iisangon-gif/Stress-Corrosion-Cracking-Test-Chamber/docs/design-notes-th.md

# บันทึกการออกแบบ (ภาษาไทย): อุปกรณ์ที่ตัดออก คำอธิบาย และการเปลี่ยนอุปกรณ์

เอกสารนี้ตอบคำถามเรื่องอุปกรณ์ของตู้พ่นหมอกน้ำเกลือ NaCl 3.5 %wt ที่ใช้ Arduino Mega 2560

---

## 0. ทำความเข้าใจให้ตรงกัน (สรุปล่าสุด)

### 0.1 ฮีตเตอร์ใช้ Solid State Relay — ถูกต้อง ไม่มีปัญหา

* ฮีตเตอร์ 220 VAC → **SSR-25DA** (สั่งด้วย DC 3–32 V จากขา D5, ตัดต่อไฟ AC แบบ zero-cross) + ฮีทซิงก์
* เฟิร์มแวร์สั่งฮีตเตอร์แบบ **เปิด-ปิดเป็นรอบเวลา 2 วินาที** (เช่นต้องการ 30 % → เปิด 0.6 s ปิด 1.4 s) ซึ่ง SSR-DA ทำได้สบาย ไม่ใช่ PWM ความถี่สูง
* ใส่ **KSD301 75 °C + thermal fuse ~100 °C** บน heat sink อนุกรมกับฮีตเตอร์ไว้เป็นชั้นป้องกันทางฮาร์ดแวร์ (ดูหัวข้อ 0.5)
* ถ้าใช้แผ่นฮีตเตอร์ **24 VDC** (แนะนำ เพราะฮีตเตอร์อยู่ในตู้ที่เปียกเกลือ) ให้ใช้ **DC/DC SSR** แทน SSR-25DA — SSR-25DA ใช้กับไฟ AC เท่านั้น

### 0.2 หัวพ่นหมอก: แหล่งจ่าย 5 VDC แยก + DC/DC Solid State Relay สั่งจาก D3

**ทำไมต้องมีสวิตช์:** Driver ของหัวพ่นสร้างสัญญาณ ~108 kHz ไปสั่นแผ่น piezo เมื่อได้ไฟ 5 V แต่ **ไม่มีขารับคำสั่ง** การสั่งพ่น/หยุดจึงต้องตัด-ต่อไฟที่เข้า driver
และขา Arduino จ่ายได้แค่ ~20 mA ขณะที่ 4 หัวกินรวม ~2 A — **DC/DC SSR ตัวเดียว** คุมทั้ง 4 หัวพร้อมกัน **ใช้ได้ตามที่ออกแบบ** ขา D3 เหมือนเดิม ไม่ต้องแก้โค้ด

```
D3  ──► SSR input (+)  [3]
GND ──► SSR input (−)  [4]      (กระแสอินพุต ~7–12 mA ขา Arduino จ่ายได้)
```

**จุดที่ต้องระวังของ DC/DC SSR: แรงดันตกคร่อม (on-state voltage drop)**
SSR แบบ DC มักมีแรงดันตกคร่อม **0.1–1.5 V** ขึ้นกับรุ่นและกระแส (รุ่นที่ภายในเป็น MOSFET ตกน้อย, รุ่นถูกที่เป็นทรานซิสเตอร์ตกมาก)
ที่ไฟ 5 V แค่ตก 0.5 V ก็เหลือ 4.5 V ซึ่ง driver บางรุ่นจะพ่นอ่อนลงหรือไม่ทำงาน — จึงแนะนำให้ **วาง SSR ตามแบบใดแบบหนึ่งนี้**:

| แบบ | การต่อ | ข้อดี | หมายเหตุ |
|---|---|---|---|
| **1. SSR อยู่ฝั่ง 12 V ก่อน Step-Down (แนะนำ ถ้า Step-Down จาก 12 V Adapter)** | 12 V Adapter (+) → **SSR out (+) [1] → (−) [2]** → Step-Down IN+ ; Step-Down OUT 5 V → driver 4 หัว | **แรงดันตกของ SSR ไม่มีผล** เพราะ step-down ยังรักษา 5 V ไว้ได้ กระแสฝั่ง 12 V แค่ ~1 A (ครึ่งหนึ่งของฝั่ง 5 V) และ 12 V อยู่ในช่วงแรงดันโหลดของ SSR ทุกรุ่น | step-down เริ่มจ่ายไฟในไม่กี่มิลลิวินาที → ยังพ่นสั้น 0.3 s ได้ |
| **2. SSR อยู่ฝั่ง 5 V (ถ้าใช้ Power Supply 5 V แยก)** | 5 V PSU (+) → **SSR out (+) [1] → (−) [2]** → driver (+) ; driver (−) → PSU (−) | ต่อง่าย | **เช็กสเปก SSR:** ช่วงแรงดันโหลดต้องครอบคลุม 5 V (เช่น "3–32 VDC" หรือ "5–60 VDC"), กระแส ≥ 10 A (เผื่อ inrush ของ driver), **วัดแรงดันที่ขั้ว driver ขณะพ่นครบ 4 หัวต้อง ≥ 4.75 V** ถ้าไม่ถึง ให้ตั้ง PSU (ถ้าปรับได้) ขึ้นเป็น ~5.3 V หรือย้ายไปแบบ 1 |

ทั้งสองแบบเป็นสวิตช์ DC ที่เปิด-ปิดเร็ว (มิลลิวินาที) → ใช้ค่าเริ่มต้น **`MIST_AC_SIDE_SWITCH 0`** (พ่นสั้นสุด 0.3 s, รอบ 4 s)
ใช้ค่า `1` เฉพาะกรณีที่ตัดไฟ **220 V** ที่เข้า adapter USB (adapter ใช้เวลา ~0.5 s กว่าจะจ่ายไฟ → พ่นสั้นสุด ~1 s)

**ข้อควรระวังอื่น:**
* **ขั้วเอาต์พุตของ SSR DC มีขั้ว (+/−)** ต่อกลับขั้วจะไม่ทำงาน/เสีย
* **กระแสรั่วขณะปิด (off-state leakage)** ของ SSR DC ~1–5 mA ปกติไม่พอให้ driver ทำงาน แต่ถ้าพบว่าหัวพ่นยังพ่นอ่อน ๆ ตอนสั่งปิด ให้ต่อ R 1 kΩ / 0.5 W คร่อมขั้วไฟเข้า driver เพื่อดึงไฟรั่วลง
* **ขนาดแหล่งจ่าย:** 4 หัว × ~0.5 A ≈ 2 A (ตรวจจากฉลากหัวพ่นจริง) → Step-Down **≥ 5 A** (เช่น XL4015 5 A; LM2596 "3 A" ใช้ต่อเนื่องได้จริงแค่ ~2 A ไม่พอ) และ 12 V Adapter ≥ 3 A (step-down ~1 A + พัดลม + Arduino)
* **GND ร่วม:** ฝั่งอินพุตของ SSR แยกไฟ (opto) แล้ว จึงไม่จำเป็นต้องต่อ GND ของ 5 V เข้ากับ Arduino

ทำไมช่วงพ่นสั้นสำคัญ: ช่วงพ่นสั้นสุดกำหนดว่า RH จะแกว่งมากแค่ไหน ในตู้ **200 ลิตร** หัวพ่น 4 หัวทำให้ RH ขึ้นเพียง **~0.25 %RH ต่อการพ่น 0.5 วินาที** (ที่ 35 °C)
จึงผ่าน ±2 %RH สบายทั้งสองแบบ (จำลอง: RH แกว่ง ~±0.3 %RH ทั้ง DC/DC SSR และแบบตัดไฟ 220 V) — แต่ถ้าเป็นตู้เล็ก 40–60 ลิตร จะขึ้น ~1 %RH ต่อ 0.5 วินาที และแบบตัดไฟ 220 V (พ่นสั้นสุด ~1 s) แกว่งถึง ±2.2 %RH

* **ไม่ใช้รีเลย์กลไก** เพราะเปิด-ปิดทุกไม่กี่วินาที อายุหน้าสัมผัสจะหมดเร็ว

ข้อความเก่าที่พูดถึง `PIN_PUMP` (ปั๊มพ่นน้ำเกลือ) มาจากดีไซน์รุ่นแรก **ไม่ใช้แล้ว** — ปัจจุบันขา D3 (`PIN_MIST`) คือสวิตช์ไฟของหัวพ่นหมอก Ultrasonic

### 0.3 หัวพ่นหมอกใช้ "จับเวลาพ่น" ใช่ไหม — ใช่

ทั้งหัวพ่นและฮีตเตอร์ใช้วิธีเดียวกันคือ **เปิด-ปิดตามสัดส่วนเวลา (time-proportioning)** ไม่มีตัวไหนใช้ PWM ความถี่สูงแล้ว ต่างกันแค่ความยาวรอบ:

| เอาต์พุต | รอบเวลา | ตัวอย่าง: ระบบคำนวณว่าต้องการ 20 % |
|---|---|---|
| ฮีตเตอร์ (SSR) | 2 s | เปิด 0.4 s / ปิด 1.6 s |
| หัวพ่นหมอก (DC/DC SSR หรือ MOSFET) | 4 s | **พ่น 0.8 s / หยุด 3.2 s** |
| หัวพ่นหมอก (SSR ตัดไฟ 220 V ของ adapter) | 6 s | พ่น 1.2 s / หยุด 4.8 s |
| พัดลมเติมอากาศ | 10 s | เปิด 2 s / ปิด 8 s |

ระยะเวลาพ่นในแต่ละรอบ **ไม่คงที่** — ตัวควบคุม (PI) คำนวณใหม่ทุก 2 วินาทีจากความชื้นที่วัดได้: ยิ่ง RH ต่ำกว่าค่าตั้งมาก ยิ่งพ่นนาน
ถ้าต้องการพ่นน้อยกว่าเวลาพ่นสั้นสุด (0.3 s) ระบบจะ "เก็บสะสม" ไว้แล้วพ่นในรอบถัดไป เช่น ต้องการ 5 % = 0.2 s ต่อรอบ → พ่น 0.4 s ทุก 2 รอบ ค่าเฉลี่ยจึงยังถูกต้อง

---

## 0.4 ช่วงการทำงานของตู้

| ค่า | ช่วงที่ตั้งได้ | วิธีควบคุม |
|---|---|---|
| อุณหภูมิ | **20–40 °C** หรือ **ROOM** | ฮีตเตอร์ (ทำความร้อนได้อย่างเดียว ไม่มีระบบทำความเย็น) |
| ความชื้น | **20–80 %RH** | **หมอกน้ำเกลือเป็นหลัก** (เพิ่ม RH), พัดลมเติมอากาศช่วยลด RH |

**โหมด ROOM (อุณหภูมิห้อง):** ในเมนู Set Temperature กด LEFT ต่ำกว่า 20.0 จะเป็น `ROOM` (หรือพิมพ์ `SET T ROOM`)
→ ปิดฮีตเตอร์ วัดและบันทึกอุณหภูมิอย่างเดียว ควบคุมเฉพาะความชื้นด้วยหมอก (ไม่เช็กช่วง ±1 °C แต่ alarm อุณหภูมิเกิน 60 °C ยังทำงาน)

**ข้อจำกัดทางฟิสิกส์ที่ต้องรู้:**

1. **อุณหภูมิต้องสูงกว่าห้องอย่างน้อย ~3 °C** เพราะไม่มีระบบทำความเย็น ถ้าห้อง 30 °C จะตั้ง 20–32 °C ไม่ได้ → ใช้โหมด ROOM หรือวางตู้ในห้องแอร์
2. **หมอกเพิ่มความชื้นได้อย่างเดียว ลดไม่ได้** RH ที่ต่ำที่สุดที่ทำได้ = ความชื้นของอากาศห้องที่เป่าเข้าไป (เมื่ออุ่นขึ้นเป็นอุณหภูมิตู้):

| อากาศห้อง | ตู้ 25 °C | ตู้ 30 °C | ตู้ 35 °C | ตู้ 40 °C |
|---|---|---|---|---|
| 25 °C / 50 %RH (ห้องแอร์) | 50 % | 37 % | 28 % | **21 %** |
| 25 °C / 60 %RH | 60 % | 45 % | 34 % | 26 % |
| 30 °C / 60 %RH | – | 60 % | 45 % | 34 % |
| 30 °C / 70 %RH (ห้องปกติในไทย) | – | 70 % | 53 % | 40 % |

   ถ้าต้องการ RH ต่ำกว่าตาราง (เช่น 20–30 %RH ที่ 25–30 °C) ต้องใช้ **อากาศแห้ง**: ใส่ **กระบอกซิลิกาเจล (desiccant) ที่ทางเข้าของพัดลมเติมอากาศ**
   (ไม่ต้องเพิ่มขาหรือแก้โค้ด — พัดลมตัวเดิมเป่าอากาศแห้งเข้า) ซิลิกาเจลต้องอบไล่ความชื้นเป็นระยะ หรือใช้ลมอัดแห้ง (compressed dry air) แทน

3. **หมอกเกลือที่ RH ต่ำกว่า ~75 %RH:** NaCl มีจุด deliquescence ที่ ~75 %RH — ต่ำกว่านี้หยดน้ำเกลือที่เกาะชิ้นงานจะแห้งเป็นผลึกเกลือ
   ซึ่งเป็นสภาวะที่ใช้ศึกษาการสะสมคลอไรด์และวัฏจักรเปียก-แห้งได้ แต่การกัดกร่อนจะช้าลงมากเมื่อเกลือแห้ง ควรออกแบบโปรไฟล์ทดสอบให้สอดคล้องกับวัตถุประสงค์

---

## 0.5 ตู้ทดสอบ 50 × 80 × 50 cm (พลาสติก) และฮีตเตอร์ภายในตู้

### ขนาดและภาระความร้อน

| รายการ | ค่า |
|---|---|
| ขนาดภายใน (W × L × H) | 50 × 80 × 50 cm → **ปริมาตร 200 ลิตร**, พื้นที่ผิว 2.1 m² |
| การสูญเสียความร้อนผ่านผนังพลาสติก 5 mm (ไม่หุ้มฉนวน) | ~6.6 W/K |
| หุ้มฉนวน XPS/PE foam 20 mm ด้านนอก | ~2.3 W/K (ลดลง ~3 เท่า) |
| ความร้อนที่หมอกใช้ระเหย (latent heat) | สูงสุด ~95 W เมื่อพ่นต่อเนื่อง 4 หัว (~26 W ที่ 40 °C / 80 %RH) |
| หัวพ่น 4 หัว (~35 mL/h ต่อหัว) ในตู้ 200 L | พ่นประมาณ 7–28 % ของเวลา เพื่อรักษา 35–40 °C / 70–80 %RH — **4 หัวเพียงพอ** |

กำลังฮีตเตอร์ที่ต้องใช้ (ห้อง 25 °C → ตู้ 40 °C / 80 %RH รวมความร้อนระเหยของหมอก):

| | ภาระคงที่ | แนะนำฮีตเตอร์ (เผื่ออุ่นเครื่อง ~2 เท่า) |
|---|---|---|
| ตู้หุ้มฉนวน 20 mm | ~70 W | **200 W** |
| ตู้ไม่หุ้มฉนวน | ~135 W | **300 W** |

ผลจำลอง (ตู้ 200 L, ฮีตเตอร์ในตู้ + พัดลม, 16 กรณี รวมฮีตเตอร์ 100–300 W, หุ้ม/ไม่หุ้มฉนวน, หมอกอ่อน/แรง, ห้องไทย 30 °C / 70 %):
**ผ่าน ±1 °C / ±2 %RH ทุกกรณี** — แย่สุด ±0.71 °C, ±1.26 %RH (ตอนฟื้นตัวหลังเปิดฝา)

**ชนิดพลาสติกของตู้:** PP หรืออะคริลิก (ทนได้ถึง ~70–100 °C) เหมาะสม — **PVC อ่อนตัวที่ ~60–70 °C** ถ้าใช้ PVC ให้ฮีตเตอร์ห่างผนัง ≥ 5 cm
ติดตั้งชุดฮีตเตอร์บนขาตั้ง/standoff ไม่ให้ครีบหรือแผ่นฮีตเตอร์แตะผนังพลาสติก

### ฮีตเตอร์อยู่ในตู้: Silicone rubber heater pad + Al heat sink มีครีบ + พัดลม — ความเสี่ยงจาก corrosion

ใช่ **มีความเสี่ยงจริง** และมีความเสี่ยงด้านไฟฟ้าด้วย:

| ชิ้นส่วน | ความเสี่ยงในหมอกเกลือ 3.5 % | ผล |
|---|---|---|
| **Al heat sink** | คลอไรด์ทำให้เกิด **pitting** โดยเฉพาะที่ครีบร้อนซึ่งหยดน้ำเกลือระเหยทิ้ง **คราบเกลือ** ไว้ (คราบดูดความชื้นกลับ → กัดกร่อนต่อเนื่อง) | ประสิทธิภาพถ่ายเทความร้อนลด, ผงขาว Al(OH)₃ หลุดปนเปื้อนตู้/ชิ้นงาน |
| **Silicone pad** | ตัวยางซิลิโคนทนเกลือได้ดี แต่ **ขอบกาวและจุดสายไฟออก** น้ำเกลือซึมเข้าได้ | แผ่นหลุดลอก, **ไฟรั่ว** |
| **ไฟ 230 V ในตู้เปียกเกลือ** | ฟิล์มน้ำเกลือนำไฟฟ้า | **อันตรายจากไฟดูด**, เบรกเกอร์กันดูดตัด |
| **พัดลม** | ลูกปืนติด, แผงวงจรมอเตอร์ถูกกัด | พัดลมหยุด → ฮีตเตอร์ร้อนเกิน |
| **ขั้วต่อ/สายไฟในตู้** | ทองแดงเป็นสนิมเขียว | ต่อไม่ติด, ร้อนที่จุดต่อ |

**แนวทางลดความเสี่ยง (เรียงตามความสำคัญ):**

1. **ใช้ฮีตเตอร์แรงดันต่ำ 24 VDC (SELV) แทน 230 VAC** — ปลอดภัยจากไฟดูดแม้ฉนวนเสื่อม
   แผ่นซิลิโคน 24 V 200–300 W มีขาย, ใช้ Power Supply 24 V ≥ 15 A, สวิตช์ด้วย **DC/DC SSR** (แบบเดียวกับหัวพ่น) จากขา D5 — ไม่ต้องแก้โค้ด
   ถ้าจำเป็นต้องใช้ 230 V: **ต่อสายดินที่ heat sink**, ใช้ **RCD/RCBO 30 mA**, และสาย/จุดต่อทั้งหมดอยู่นอกตู้
2. **เคลือบป้องกัน Al heat sink** (เลือกอย่างใดอย่างหนึ่ง):
   * Hard anodize + seal (ดีที่สุดสำหรับ Al, ความร้อนผ่านได้ดี)
   * Epoxy / powder coat บาง ๆ 50–80 µm (ความร้อนลดลงเล็กน้อย ~5–10 %)
   * หรือเปลี่ยนวัสดุครีบเป็น **สแตนเลส 316** (นำความร้อนต่ำกว่า ต้องครีบใหญ่ขึ้น) หรือ **ไทเทเนียม** (ทนที่สุด แพง)
3. **ปิดผนึกแผ่นฮีตเตอร์และสายไฟ**:
   * ทาขอบแผ่นซิลิโคนด้วย **RTV silicone ชนิด neutral cure** (ห้ามใช้ชนิด acetoxy/กลิ่นน้ำส้มสายชู เพราะกรดอะซิติกกัดโลหะ)
   * ใช้สายหุ้มซิลิโคนเส้นเดียวยาวต่อเนื่อง **ไม่มีจุดต่อในตู้** ออกผ่าน cable gland ไปต่อในกล่องควบคุม
4. **วางชุดฮีตเตอร์ให้ห่างละอองหมอก**: ตั้งไว้มุมตรงข้ามกับหัวพ่น มี **แผ่นกันหยด (drip shield)** ด้านบน ให้พัดลมดูดอากาศผ่านครีบ ไม่ใช่ให้หมอกพ่นใส่ครีบ — ครีบร้อน + หยดน้ำเกลือ = คราบเกลือสะสมเร็วที่สุด
5. **พัดลม**: ใช้ **IP68 brushless** (มอเตอร์และแผงวงจรถูก potting) และถือเป็นของสิ้นเปลือง พัดลมนี้คือ `PIN_CIRC_FAN` (D7) ซึ่งเปิดตลอดเวลาที่ระบบ RUN — ฮีตเตอร์จึงไม่ทำงานโดยไม่มีลม
6. **ป้องกันความร้อนเกินเมื่อพัดลมเสีย** (ซอฟต์แวร์ตรวจไม่ได้ว่าพัดลมหมุน):
   * **Bimetal thermostat KSD301 ชนิด NC 75 °C** ยึดบน heat sink อนุกรมกับฮีตเตอร์ (ตัดอัตโนมัติ, ต่อกลับเมื่อเย็น)
   * **Thermal fuse ~100 °C** อนุกรมอีกชั้น (ตัดถาวร)
   * ปกติ heat sink ร้อนกว่าอากาศ ~20 °C ที่กำลังเต็ม (สูงสุด ~60 °C ที่ตู้ 40 °C) จึงไม่ตัดผิดจังหวะ
7. **ออกแบบให้ถอดเปลี่ยนง่าย**: ทำชุดฮีตเตอร์ + พัดลมเป็นโมดูลเดียว ต่อด้วยขั้วต่อกันน้ำนอกตู้ — ล้างด้วยน้ำ DI หลังทดสอบทุกครั้ง และตรวจสภาพทุกเดือน

**ทางเลือกที่หลีกเลี่ยง corrosion ได้ดีกว่า** (ถ้าออกแบบใหม่ได้): แปะแผ่นฮีตเตอร์ไว้ **ด้านนอก** ของผนัง/พื้นที่ทำจาก **แผ่นอะลูมิเนียมบางเคลือบ epoxy ด้านใน**
แล้วใช้พัดลม IP68 ในตู้ช่วยกวนอากาศ — ฮีตเตอร์และไฟ 230 V ไม่สัมผัสหมอกเลย (ดูหัวข้อ 2.4) แต่การถ่ายเทความร้อนช้ากว่าแบบฮีตเตอร์ในตู้

---

## 1. บอร์ด Arduino Mega 2560, Buzzer, LED แสดงสถานะ และอุปกรณ์ที่ไม่ติดตั้ง

**เปลี่ยนเป็น Arduino Mega 2560:** Flash ใช้ ~34 KB จาก 256 KB และ RAM ~1.5 KB จาก 8 KB จึงเหลือที่และขาว่างอีกมากสำหรับต่อเพิ่มภายหลัง
(โค้ดจะไม่ยอม compile ถ้าเลือกบอร์ดเป็น UNO เพื่อป้องกันการอัปโหลดผิดบอร์ด เพราะขา LED D22–D28 มีเฉพาะบน Mega)

| ขา Mega | อุปกรณ์ | หมายเหตุ |
|---|---|---|
| D2 | DHT22 | |
| D3 | DC/DC SSR → หัวพ่นหมอก 4 หัว | |
| D5 | SSR → ฮีตเตอร์ | |
| D6 | พัดลมเติมอากาศ | |
| D7 | พัดลมผ่านครีบฮีตเตอร์ | |
| **D8** | **Buzzer 5 V** (ใส่กลับมาแล้ว) | |
| **D22** | **LED เขียว RUN** | ติดค้าง = อยู่ในช่วง ±1 °C / ±2 %RH, กะพริบช้า = กำลังเข้าสู่ค่าตั้ง, ดับ = หยุด |
| **D24** | **LED แดง ALARM** | กะพริบเร็ว = alarm ใหม่, ติดค้าง = รับทราบแล้วแต่ยังมี alarm, ดับ = ปกติ |
| **D26** | **LED เหลือง/ส้ม HEATER** | ติดเมื่อฮีตเตอร์ทำงาน |
| **D28** | **LED น้ำเงิน MIST** | ติดเมื่อหัวพ่นทำงาน |
| D20/D21 (SDA/SCL) | LCD shield + **โมดูล DS3231** | LCD ใช้ขา SDA/SCL ข้าง AREF, DS3231 ต่อสายเข้าขาเดียวกัน |
| D50 / D51 / D52 / D53 | **โมดูล Micro SD 6 ขา** (MISO / MOSI / SCK / CS) | VCC ต่อ 5 V, ใช้รุ่นที่มี AMS1117 + 74LVC125A, สายสั้น ≤ 15–20 cm (ดู wiring.md §1.1) |

* **ต่อ LED:** ขา → R 330 Ω → LED → GND (หรือใช้ LED ติดหน้าตู้แบบ 5 V ที่มี R ในตัว) ถ้าเป็นหลอดไฟ 12/24 V ต้องขับผ่าน MOSFET/ทรานซิสเตอร์
* **ปุ่มแบบมีไฟในตัว** ยังใช้ได้ โดยต่อ LED ของปุ่มเข้ากับ D22–D28 แทน LED ธรรมดา
* **ตอนเปิดเครื่อง:** LED ทั้ง 4 ดวงติดพร้อมกัน และ Buzzer ดังสั้น 1 ครั้ง (lamp test) เพื่อเช็กว่าทำงานครบ

**Data Logging (แบบ A):** ใช้ **โมดูล Micro SD 6 ขา + โมดูล DS3231** แยกกัน แทน Data Logging Shield
ค่าใน `config.h` ตั้งไว้ให้แล้ว: `RTC_IS_PCF8523 0` (DS3231) และ `PIN_SD_CS 53`
* DS3231 รุ่น ZS-042 มีวงจรชาร์จถ่าน — ใช้ถ่าน **LIR2032** (ชาร์จได้) หรือถ้าใช้ CR2032 ให้ถอดไดโอด/R ชาร์จออก
* ใส่ DS3231 ครั้งแรกแล้วตั้งเวลา 1 ครั้ง: `TIME 2026-10-14 09:00:00`

**ต่ออุปกรณ์ทีละชิ้นได้ — โค้ดรันได้แม้อุปกรณ์ยังไม่ครบ:**

| ยังไม่มี | ผล |
|---|---|
| Micro SD / การ์ด | บันทึกผ่าน USB (Serial) ต่อไป, จอหน้า Log ขึ้น `SD --` |
| DS3231 | เวลาในข้อมูลเป็น "วินาทีนับจากเปิดเครื่อง", ไฟล์ชื่อ `DATALOG.CSV` |
| จอ LCD | ควบคุมทำงานปกติ ตั้งค่าผ่าน Serial |
| DHT22 | `!SENSOR FAIL` — **ปิดฮีตเตอร์และหัวพ่นไว้** (ป้องกันความปลอดภัย) และ Buzzer ดัง |
| SSR / โหลด / LED / Buzzer | ขายังสั่งงานปกติ (ดู LED ส้ม/น้ำเงินเพื่อเช็กลอจิกก่อนต่อโหลดจริง) |

* **ตอนเปิดเครื่อง** Serial Monitor แสดงบรรทัดเดียวว่าเจออะไรบ้าง เช่น `# LCD OK | RTC OK 2026-10-14 09:00:00 | SD not found | DHT22 OK` และพิมพ์ `DEVICES` เพื่อดูอีกครั้งได้ตลอด
* **ระบบค้นหาอุปกรณ์ที่ขาดทุก 1 นาที** — ใส่การ์ด SD / DS3231 / จอ ทีหลังได้โดย **ไม่ต้องกด Reset** (ขึ้นข้อความ `# SD card found`, `# RTC found`, `# LCD found`)
  ระหว่างค้นหาการ์ด SD ที่ยังไม่มี (ใช้เวลา ~2 วินาที) ระบบจะปิดฮีตเตอร์และหัวพ่นไว้ชั่วคราวเพื่อความปลอดภัย
* **ดึงการ์ดออกระหว่างทำงาน** ระบบยังควบคุมต่อ แจ้ง `SD write failed` แล้วค้นหาใหม่เอง
* **บัส I²C มี timeout** — ถ้าสาย I²C หลวม/ช็อต ระบบจะ reset บัสแทนการค้าง
* **ต่อ/ถอดอุปกรณ์ตอนปิดไฟเสมอ**
* เมนู **Reset stats** กลับมาแล้ว (ตอน UNO ต้องตัดออกเพราะหน่วยความจำไม่พอ)

**ไม่ติดตั้ง (ตามที่เลือก):**

| ไม่ติดตั้ง | ผลกระทบ / สิ่งที่ทดแทน |
|---|---|
| ลูกลอยระดับน้ำเกลือ | ผู้ใช้ต้อง **ตรวจระดับน้ำเกลือเอง** ถ้าน้ำหมด ความชื้นจะตกจนเกิด alarm `!OUT OF BAND` แล้ว Buzzer และ LED แดงจะเตือน |
| Reed switch ฝาตู้ | ก่อนเปิดฝาให้สั่ง **STOP** (เมนู Run / Stop หรือพิมพ์ `STOP`) แล้วกด RUN เมื่อปิดฝา |
| DS18B20 | ใช้ DHT22 ตัวเดียววัดทั้ง T และ RH |

ถ้าต้องการเพิ่มภายหลัง Mega มีขาว่างเหลือ: D4, D9, D11–D13, D23, D25, D27, D29–D49, A0–A15

---

## 2. คำอธิบายอุปกรณ์

### 2.1 ทำไมขา `PIN_ONEWIRE` ต้องต่อ R 4.7 kΩ ไป 5 VDC

1-Wire (DS18B20) และสายข้อมูลของ DHT22 เป็นบัสแบบ **open-drain** อุปกรณ์ทุกตัวบนสาย **ดึงสายลง 0 V ได้อย่างเดียว ดึงขึ้นเองไม่ได้**

* เวลาไม่มีใครดึงลง ตัวต้านทาน pull-up จะดึงสายกลับขึ้นเป็น 5 V (logic 1) ถ้าไม่มี สายจะ "ลอย" อ่านค่าเพี้ยนหรืออ่านไม่ได้เลย
* ค่า **4.7 kΩ** เป็นจุดสมดุล ต่ำพอให้สายขึ้นเป็น 1 ได้เร็ว (สายยาวมีความจุ ถ้า R สูงเกิน ขอบสัญญาณจะช้าจนอ่านบิตผิด) และสูงพอให้อุปกรณ์ดึงลงได้โดยกินกระแสไม่เกิน ~1 mA
* DS18B20 แบบ parasite power ยังใช้ pull-up นี้เป็นแหล่งจ่ายไฟด้วย
* pull-up ภายในของ Arduino (~20–50 kΩ) อ่อนเกินไปสำหรับสายยาว

ในดีไซน์ปัจจุบันใช้ **DHT22** ซึ่งก็ต้องใช้ pull-up ด้วยเหตุผลเดียวกัน (4.7–10 kΩ) แต่ **AM2302 รุ่นมีสายมี pull-up ในตัวแล้ว** ไม่ต้องต่อเพิ่ม ถ้าใช้ DHT22 แบบ 4 ขาเปล่า ให้ต่อ 10 kΩ จาก DATA ไป 5 V (สายยาวเกิน 3 m ใช้ 4.7 kΩ)

### 2.2 Buzzer (D8) และ LED แดง แจ้งเตือนตอนไหน

Buzzer ดัง (0.4 s ทุก 1.2 s) และ LED แดงกะพริบเร็ว เมื่อมี alarm ที่ยังไม่ได้รับทราบ:

| Alarm | เกิดเมื่อ | ระบบทำอะไร |
|---|---|---|
| `!SENSOR FAIL` | DHT22 อ่านไม่ได้ 3 ครั้งติด (6 s) | ปิดฮีตเตอร์และหัวพ่นทันที |
| `!OVER TEMP` | อุณหภูมิ ≥ 60 °C | ปิดฮีตเตอร์และหัวพ่น เปิดพัดลมเติมอากาศ 100 % |
| `!OUT OF BAND` | หลังเข้าสู่ช่วงเสถียรแล้ว T หรือ RH หลุดช่วง ±1 °C / ±2 %RH นานเกิน 10 นาที (เช่น น้ำเกลือหมด, ลืมปิดฝา, ฮีตเตอร์เสีย) | แจ้งเตือนอย่างเดียว ยังควบคุมต่อ |

* **กดปุ่มใดก็ได้บน LCD shield = รับทราบ:** Buzzer เงียบ และ LED แดงเปลี่ยนจากกะพริบเป็น **ติดค้าง** จนกว่าปัญหาจะหายหรือมี alarm ใหม่ (ซึ่งจะดังอีกครั้ง)
* ไฟพื้นหลัง LCD เป็น **สีแดง** ตลอดเวลาที่มี alarm
* Buzzer แบบ active 5 V ที่กินกระแส ≤ 20 mA ต่อตรงขา D8 ได้ ถ้าเป็น buzzer เสียงดัง 12 V ให้ขับผ่าน MOSFET/ทรานซิสเตอร์

### 2.3 ทำไมใช้ MOSFET — ใช้ Solid State Relay (SSR) แทนได้ไหม

**ใช้ SSR ได้** เฟิร์มแวร์ปรับแล้วให้ **ทุกเอาต์พุตเป็นแบบ on/off ตามสัดส่วนเวลา (time-proportioning)** ไม่ได้ใช้ PWM ความถี่สูงแล้ว:

| เอาต์พุต | หน้าต่างเวลา | ตัวอย่าง: 25 % |
|---|---|---|
| ฮีตเตอร์ | 2 s | ON 0.5 s / OFF 1.5 s |
| หัวพ่นหมอก 4 หัว | 4 s (MOSFET) / 6 s (SSR) | ON 1.0 s / OFF 3.0 s |
| พัดลมเติมอากาศ | 10 s | ON 2.5 s / OFF 7.5 s |

เหตุผล: PWM 980 Hz (`analogWrite`) **ใช้กับ SSR ไม่ได้** เพราะ SSR AC แบบ zero-cross จะเปิด/ปิดได้เฉพาะตอนแรงดันไฟ AC ผ่านศูนย์ (ทุก 10 ms ที่ 50 Hz) จึงต้องใช้รอบเวลาช้าระดับวินาที ซึ่งตอนนี้รองรับแล้ว

เลือกอุปกรณ์สวิตช์ตามชนิดโหลด:

| โหลด | อุปกรณ์ที่เหมาะ | หมายเหตุ |
|---|---|---|
| ฮีตเตอร์ **220 VAC** | **SSR-25DA** (DC in 3–32 V, AC out, zero-cross) + ฮีทซิงก์ | ดีที่สุดสำหรับฮีตเตอร์ AC: แยกไฟ (isolation), ไม่มีหน้าสัมผัสสึก, ไม่มีสัญญาณรบกวน |
| ฮีตเตอร์/พัดลม **12 VDC** | MOSFET module (logic-level) หรือ **SSR แบบ DC-DC** (เช่น SSR-10DD) | **ห้ามใช้ SSR-DA (AC out) กับไฟ DC** — มันจะปิดไม่ได้ เพราะไม่มีจุดผ่านศูนย์ |
| หัวพ่นหมอก **5 V** (driver 4 หัว) | **DC/DC SSR** (เลือกใช้) หรือ MOSFET module | วาง SSR **ฝั่ง 12 V ก่อน step-down** ดีที่สุด; ถ้าวางฝั่ง 5 V ต้องเช็กแรงดันตกคร่อม (ดูหัวข้อ 0.2) |
| ทุกชนิด | **ห้ามใช้รีเลย์กลไก** กับหัวพ่นและฮีตเตอร์ | เปิด-ปิดทุก 2–5 วินาที = ~20,000 ครั้ง/วัน รีเลย์ (อายุ ~100,000 ครั้ง) จะพังภายในประมาณ 1 สัปดาห์ |

เปรียบเทียบ MOSFET vs SSR:

| | MOSFET module | SSR |
|---|---|---|
| ราคา | ถูก | แพงกว่า (ระวังของปลอม) |
| ความร้อน/แรงดันตก | น้อยมาก (mΩ) | DA: ~1.5 V, ต้องมีฮีทซิงก์เมื่อ > 5 A |
| แยกไฟ (isolation) | ไม่แยก (GND ร่วม) | **แยกด้วย opto** ปลอดภัยกว่าเมื่อคุมไฟบ้าน |
| คุมไฟ AC 220 V | ไม่ได้ | ได้ (SSR-DA) |
| คุมไฟ DC แรงดันต่ำ | ดีมาก | ได้ (SSR-DD) — มีแรงดันตกคร่อม 0.1–1.5 V จึงควรวางฝั่ง 12 V |

**สรุป (ตามที่เลือกใช้):** **SSR-25DA** สำหรับฮีตเตอร์ 220 VAC (D5) และ **DC/DC SSR** สำหรับไฟของหัวพ่นหมอก (D3) วางฝั่ง 12 V ก่อน step-down —
พัดลม 12 V (D6, D7) ใช้ DC/DC SSR หรือ MOSFET module ก็ได้

### 2.4 ฮีตเตอร์และพัดลมจะเกิด corrosion ในหมอกน้ำเกลือ 3.5 %wt NaCl ไหม

> **อัปเดต:** ดีไซน์ปัจจุบันใช้ฮีตเตอร์ **ภายในตู้** (silicone pad + Al heat sink + พัดลม) ตามที่เลือก — ดูวิธีป้องกันที่หัวข้อ **0.5** หัวข้อนี้เก็บไว้เป็นทางเลือก "ฮีตเตอร์นอกตู้"

**เกิดแน่นอน ถ้าอยู่ในหมอกโดยตรง** หมอกเกลือคือสิ่งที่ตู้นี้ถูกสร้างมาเพื่อกัดกร่อนโลหะ:

* **ฮีตเตอร์ PTC ครีบอะลูมิเนียม / ฮีตเตอร์ขดลวด**: อะลูมิเนียมเกิด pitting, ขั้วต่อทองแดงเป็นสนิมเขียว, ครีบมีคราบเกลือเกาะ ประสิทธิภาพลดลง และเสี่ยง **ไฟรั่ว/ลัดวงจร** เพราะคราบเกลือชื้นนำไฟฟ้าได้
* **พัดลม DC ทั่วไป**: ลูกปืน/บูชฝืดและติด, แผงวงจรขับมอเตอร์ (brushless) ถูกกัดจนเสีย, ขดลวดและสายเป็นสนิม — พัดลมธรรมดาอยู่ได้ระดับ **วันถึงสัปดาห์**
* **ผลต่อการทดสอบ**: ไอออนโลหะจากชิ้นส่วนที่ผุ (Cu, Fe, Al, Zn) ปนเปื้อนหมอกและชิ้นงาน ทำให้ผลการทดสอบ SCC เพี้ยน

**วิธีแก้ในดีไซน์นี้ — เอาฮีตเตอร์และพัดลมออกไปอยู่นอกหมอก:**

1. **ฮีตเตอร์ → แผ่นฮีตเตอร์ซิลิโคน (silicone rubber heater pad) ติดผนังด้านนอกของตู้** ใต้ฉนวน ความร้อนผ่านผนังเข้าไป ไม่สัมผัสหมอกเลย
   * แนะนำทำ **พื้นหรือผนังด้านหนึ่งเป็นแผ่นอะลูมิเนียมบาง (2–3 mm) เคลือบ epoxy/PP ด้านใน** แล้วแปะ heater pad ด้านนอก เพื่อให้ความร้อนผ่านได้ดี (ผนังพลาสติกหนา ≥ 10 mm ถ่ายเทความร้อนช้า จนควบคุม ±1 °C ได้ยากหลังเปิดฝา — ดูผลจำลองกรณี `thick_wall_slow_heater`)
   * ทางเลือก: **อ่างน้ำ (water jacket) ใต้ตู้ + ฮีตเตอร์ไทเทเนียม** (แบบตู้ salt spray เชิงพาณิชย์) อุณหภูมิสม่ำเสมอมาก แต่ตอบสนองช้า ต้องจูน PID ใหม่
2. **พัดลมระบายความชื้น → พัดลมเติมอากาศ (fresh-air blower) ติดตั้งด้านนอก เป่าอากาศห้องที่สะอาดเข้าไป** ส่วนทางออกเป็นรูระบายแบบ passive (ท่อ PVC ลงด้านล่าง มีกับดักน้ำ) — มอเตอร์สัมผัสแค่อากาศห้อง ไม่ใช่หมอกเกลือ ใส่ check valve/flap กันหมอกย้อนเข้าพัดลมตอนหยุดหมุน
3. **พัดลมหมุนเวียนในตู้ (ไม่บังคับ)** — ถ้าจำเป็นต้องใช้ ให้ใช้ **พัดลมกันน้ำ IP68 แบบ brushless** เคลือบสายและจุดบัดกรีด้วย epoxy/silicone และถือเป็น **ของสิ้นเปลือง** เปลี่ยนตามรอบ หรือไม่ใช้เลยแล้วอาศัยการหมุนเวียนจากหมอกและความร้อนจากผนัง (อุณหภูมิในตู้อาจไม่สม่ำเสมอเท่า ควรวัดหลายจุดตอนทดสอบระบบ)
4. **DHT22 ก็อยู่ในหมอกเช่นกัน** ใช้รุ่นที่มีฝาครอบกรอง (PTFE/sintered), เคลือบขาและสายด้วย conformal coating, ติดในจุดที่หมอกไม่พ่นใส่ตรง ๆ และ **ตรวจสอบ/เปลี่ยนเป็นระยะ** (ค่า RH ใกล้ 100 % และคราบเกลือทำให้ค่าดริฟต์)
5. **วงจรทั้งหมด** (Arduino, MOSFET, SSR, power supply) อยู่ในกล่อง IP65 **นอกตู้** สายทุกเส้นผ่านเคเบิลแกลนด์

---

## 3. อุปกรณ์ที่เปลี่ยน: หัวพ่นหมอก Ultrasonic 4 หัว

* หัวพ่น 4 หัวมีบอร์ดขับในตัว ใช้ไฟ USB 5 V และ **ทำงานพร้อมกันทั้ง 4 หัว** จึงใช้ **เอาต์พุตเดียว (D3, `PIN_MIST`)** สวิตช์ไฟ 5 V ที่จ่ายรวมให้ทั้ง 4 หัว
* แหล่งจ่าย: **Step-Down 12→5 V ≥ 5 A** (เช่น XL4015) จาก 12 V Adapter ≥ 3 A หรือ Power Supply 5 V แยก ≥ 3 A — 4 หัว × ~0.5 A ≈ 2 A (ดูฉลากหัวพ่นจริง) สวิตช์ด้วย **DC/DC SSR ตัวเดียว** จากขา D3 (ดูหัวข้อ 0.2)
* หัวพ่นต้อง **เริ่มพ่นทันทีเมื่อได้รับไฟ** (ไม่ต้องกดปุ่ม) ไม่อย่างนั้น Arduino สั่งเปิดไม่ได้
* น้ำเกลือ 3.5 %wt: แผ่น piezo ทำงานได้ แต่ **คราบเกลือจะเกาะและแผ่นสึกเร็วกว่าน้ำเปล่า** ควรล้างด้วยน้ำ DI หลังทดสอบทุกครั้ง และเตรียมหัวสำรอง
* **ไม่ต้องทำตาม ASTM B117** — ไม่ต้องวัดอัตราการตกของหมอก (collection rate) อุณหภูมิและความชื้นตั้งได้อิสระตามที่ต้องการ
* ไม่มีลูกลอยแล้ว: **ห้ามให้น้ำเกลือในถังหมด** ถ้าหัวพ่นชนิดไม่มีระบบตัดเมื่อแห้ง แผ่น piezo จะร้อนและเสีย — เติมน้ำเกลือให้พอสำหรับรอบทดสอบ (ดูอัตราใช้น้ำจากสเปกหัวพ่น เช่น 4 × 30 mL/h ≈ 3 ลิตร/วัน ที่ duty 100 %; จริงจะใช้น้อยกว่าเพราะพ่นเป็นช่วง)

### การเตรียมน้ำเกลือ NaCl 3.5 %wt

**NaCl 35.0 g + น้ำ DI 965.0 g = สารละลาย 1,000 g** (ไม่ใช่ NaCl 35 g ในน้ำ 1 ลิตร ซึ่งจะได้ 3.38 %wt)

| ต้องการ | NaCl | น้ำ DI |
|---|---|---|
| 1 kg | 35.0 g | 965.0 g |
| 5 kg | 175.0 g | 4,825.0 g |
| 10 kg | 350.0 g | 9,650.0 g |
