iisangon-gif/Stress-Corrosion-Cracking-Test-Chamber/firmware/SCC_EnvControl/SCC_EnvControl.ino

// =====================================================================
//  SCC Chamber Environmental Control  —  Arduino Mega 2560
//
//  Controls temperature and relative humidity of the 3.5 wt% NaCl salt
//  fog inside a stress-corrosion-cracking (SCC) test chamber:
//    * DHT22 (AM2302) temperature / humidity sensor
//    * 4 x USB ultrasonic mist heads (one 5 V supply, switched together)
//                                         -> salt fog / humidity up
//    * heater outside the fog (silicone pad / SSR) -> temperature up
//    * fresh-air blower outside the fog   -> humidity / temperature down
//    * circulation fan (optional, IP68)   -> uniform chamber air
//    * 16x2 I2C LCD keypad shield (5 buttons) for set-points
//    * CSV logging to a microSD module (DS3231 time stamps) and USB serial
//    * buzzer + 4 status LEDs; every module may be fitted later
//  Every output is switched on/off (time-proportioning), so MOSFET modules,
//  DC-input solid state relays or AC SSRs can all be used.
//
//  Target tolerance: +/-1.0 degC and +/-2.0 %RH (see config.h)
//
//  Libraries (Arduino Library Manager):
//    "DHT sensor library" (Adafruit) + "Adafruit Unified Sensor"
//    "Adafruit RGB LCD Shield Library"
//    SD, Wire, EEPROM (built in)
// =====================================================================
#include <Wire.h>
#include <EEPROM.h>
#include <DHT.h>
#include <Adafruit_RGBLCDShield.h>
#include "config.h"

#if !defined(ARDUINO_AVR_MEGA2560) && !defined(HOST_SIM)
  #error "Select Tools > Board > Arduino AVR Boards > Arduino Mega or Mega 2560"
#endif

#ifdef USE_SD
  #include <SPI.h>
  #include <SD.h>
#endif
#ifdef __AVR__
  #include <avr/wdt.h>
#endif

// ---------------------------------------------------------------------
//  Settings stored in EEPROM
// ---------------------------------------------------------------------
#define CFG_MAGIC 0xEC01

struct Settings {
  uint16_t magic;
  float    tSet;
  float    rhSet;
  uint16_t logSec;
  uint8_t  running;
};
Settings cfg;

// ---------------------------------------------------------------------
//  Alarms
// ---------------------------------------------------------------------
#define ALM_SENSOR    0x01   // DHT22 not responding
#define ALM_OVERTEMP  0x02   // above T_ABS_MAX
#define ALM_BAND      0x08   // out of tolerance too long after being stable
uint8_t alarms = 0;
uint8_t alarmsMuted = 0;     // alarms acknowledged by a key press

// ---------------------------------------------------------------------
//  Hardware
// ---------------------------------------------------------------------
DHT dht(PIN_DHT, DHT_TYPE);
Adafruit_RGBLCDShield lcd;

#define LCD_I2C_ADDR 0x20      // MCP23017 on the RGB LCD shield
bool lcdOk = false;
#ifdef USE_RTC
  bool rtcOk = false;
#endif
#ifdef USE_SD
  bool sdOk = false;
#endif
unsigned long lastDeviceCheckMs = 0;

// ---------------------------------------------------------------------
//  Process values and controller state
// ---------------------------------------------------------------------
float tMeas = NAN, rhMeas = NAN;
uint8_t sensorFails = 0;

float tInt = 0, rhInt = 0;     // integral terms (%)
float rhOut = 0;               // humidity PI output, -100..+100 (split range)
float tPrev = NAN;             // for derivative on measurement
float rhPrev = NAN;
float tSlope = 0, rhSlope = 0; // filtered rate of change per s (integral gating)
float heaterPct = 0, mistPct = 0, ventPct = 0;
bool  heaterOn = false, mistOn = false, ventOn = false, circOn = false;

// statistics (valid after the chamber became stable)
bool     stable = false;
bool     inBandNow = false;   // last control step was within tolerance
unsigned long inBandSinceMs = 0;
unsigned long outBandSinceMs = 0;
uint32_t statSamples = 0, statInBand = 0;
float    maxDevT = 0, maxDevRH = 0;

unsigned long lastCtrlMs = 0, lastLogMs = 0, lastLcdMs = 0, lastKeyPollMs = 0;

// ---------------------------------------------------------------------
//  UI state
// ---------------------------------------------------------------------
enum { SCR_MAIN, SCR_OUTPUTS, SCR_STATS, SCR_LOG, SCR_COUNT };
enum { MENU_TSET, MENU_RHSET, MENU_LOG, MENU_RUN, MENU_RESET, MENU_COUNT };

uint8_t screen = SCR_MAIN;
bool    inMenu = false;
uint8_t menuItem = 0;
Settings edit;                 // working copy while in the menu
bool    resetRequested = false;
unsigned long lastKeyMs = 0;
uint8_t backlight = 0xFF;

char serialBuf[40];
uint8_t serialLen = 0;

// =====================================================================
//  Helpers
// =====================================================================
inline float clampf(float v, float lo, float hi) { return v < lo ? lo : (v > hi ? hi : v); }

void printDevices();
void checkDevices();

// tSet == 0 means "ROOM": no temperature control, temperature is only logged
#define T_ROOM 0.0f
inline bool roomMode(float tSet) { return tSet < T_SET_MIN - 0.05f; }

// Fixed-point float formatting / parsing without dtostrf, atof or
// Print::print(float) — compact code (originally written to fit an UNO).
char *fmtFixed(char *out, float v, int8_t width, uint8_t dec) {
  static const uint16_t scale[] = {1, 10, 100};
  if (dec > 2) dec = 2;
  bool neg = v < 0;
  long n = (long)((neg ? -v : v) * scale[dec] + 0.5f);
  char body[12];
  if (dec) snprintf_P(body, sizeof(body), PSTR("%s%ld.%0*ld"), neg ? "-" : "", n / scale[dec], dec, n % scale[dec]);
  else     snprintf_P(body, sizeof(body), PSTR("%s%ld"), neg ? "-" : "", n);
  snprintf_P(out, 12, PSTR("%*s"), width, body);
  return out;
}

float parseNum(const char *s) {
  float sign = 1, v = 0, div = 0;
  if (*s == '-') { sign = -1; s++; } else if (*s == '+') s++;
  if (!*s) return NAN;
  for (; *s; s++) {
    if (*s == '.' && div == 0) div = 1;
    else if (*s >= '0' && *s <= '9') { v = v * 10 + (*s - '0'); if (div) div *= 10; }
    else return NAN;
  }
  return sign * (div ? v / div : v);
}

// ---------------------------------------------------------------------
//  Minimal RTC driver (DS1307 or PCF8523, both at I2C 0x68, BCD registers)
// ---------------------------------------------------------------------
#ifdef USE_RTC
#define RTC_ADDR 0x68
#if RTC_IS_PCF8523
  #define RTC_TIME_REG 0x03   // seconds .. years
  #define RTC_DAY_IDX  3      // order: s m h day weekday month year
  #define RTC_WD_IDX   4
#else
  #define RTC_TIME_REG 0x00   // DS1307: s m h weekday day month year
  #define RTC_DAY_IDX  4
  #define RTC_WD_IDX   3
#endif

struct Clock { uint8_t yy, mo, dd, hh, mi, ss; };

inline uint8_t bcd2bin(uint8_t v) { return v - 6 * (v >> 4); }
inline uint8_t bin2bcd(uint8_t v) { return v + 6 * (v / 10); }

void rtcWriteReg(uint8_t reg, uint8_t val) {
  Wire.beginTransmission(RTC_ADDR);
  Wire.write(reg);
  Wire.write(val);
  Wire.endTransmission();
}

bool rtcBegin() {
  Wire.beginTransmission(RTC_ADDR);
  if (Wire.endTransmission() != 0) return false;
#if RTC_IS_PCF8523
  rtcWriteReg(0x00, 0x00);   // Control_1: clear STOP -> oscillator running
  rtcWriteReg(0x02, 0x00);   // Control_3: battery switch-over enabled
#endif
  return true;
}

bool rtcRead(Clock &c) {
  if (!rtcOk) return false;
  Wire.beginTransmission(RTC_ADDR);
  Wire.write(RTC_TIME_REG);
  if (Wire.endTransmission() != 0) return false;
  if (Wire.requestFrom(RTC_ADDR, 7) != 7) return false;
  uint8_t r[7];
  for (uint8_t i = 0; i < 7; i++) r[i] = Wire.read();
  c.ss = bcd2bin(r[0] & 0x7F);
  c.mi = bcd2bin(r[1] & 0x7F);
  c.hh = bcd2bin(r[2] & 0x3F);
  c.dd = bcd2bin(r[RTC_DAY_IDX] & 0x3F);
  c.mo = bcd2bin(r[5] & 0x1F);
  c.yy = bcd2bin(r[6]);
  return c.mo >= 1 && c.mo <= 12 && c.dd >= 1 && c.dd <= 31;
}

// "YYYY-MM-DD HH:MM:SS"
bool rtcSetFromText(const char *t) {
  if (strlen(t) < 19 || t[4] != '-' || t[7] != '-' || t[13] != ':' || t[16] != ':') return false;
  uint8_t v[6];
  static const uint8_t pos[6] = {2, 5, 8, 11, 14, 17};   // yy mo dd hh mi ss
  for (uint8_t i = 0; i < 6; i++) {
    if (!isdigit(t[pos[i]]) || !isdigit(t[pos[i] + 1])) return false;
    v[i] = (t[pos[i]] - '0') * 10 + (t[pos[i] + 1] - '0');
  }
  if (v[1] < 1 || v[1] > 12 || v[2] < 1 || v[2] > 31 || v[3] > 23 || v[4] > 59 || v[5] > 59) return false;
  uint8_t r[7];
  r[0] = bin2bcd(v[5]);              // seconds (clears DS1307 CH / PCF8523 OS bit)
  r[1] = bin2bcd(v[4]);
  r[2] = bin2bcd(v[3]);              // 24 h mode
  r[RTC_DAY_IDX] = bin2bcd(v[2]);
  r[RTC_WD_IDX]  = 0;                // weekday not used
  r[5] = bin2bcd(v[1]);
  r[6] = bin2bcd(v[0]);
  Wire.beginTransmission(RTC_ADDR);
  Wire.write(RTC_TIME_REG);
  for (uint8_t i = 0; i < 7; i++) Wire.write(r[i]);
  return Wire.endTransmission() == 0;
}
#endif

void loadDefaults() {
  cfg.magic   = CFG_MAGIC;
  cfg.tSet    = DEF_T_SET;
  cfg.rhSet   = DEF_RH_SET;
  cfg.logSec  = DEF_LOG_SEC;
  cfg.running = 1;
}

void saveSettings() { EEPROM.put(0, cfg); }

void loadSettings() {
  EEPROM.get(0, cfg);
  if (cfg.magic != CFG_MAGIC || isnan(cfg.tSet) || isnan(cfg.rhSet)) {
    loadDefaults();
    saveSettings();
  }
}

void resetStats() {
  stable = false;
  inBandSinceMs = 0;
  outBandSinceMs = 0;
  statSamples = statInBand = 0;
  maxDevT = maxDevRH = 0;
  alarms &= ~ALM_BAND;
}

void applySettings(const Settings &s) {
  bool spChanged = (s.tSet != cfg.tSet) || (s.rhSet != cfg.rhSet) || (s.running != cfg.running);
  cfg = s;
  cfg.magic = CFG_MAGIC;
  saveSettings();
  if (spChanged) resetStats();
}

// =====================================================================
//  Outputs
// =====================================================================
void writeLoad(uint8_t pin, bool on) {
  digitalWrite(pin, on ? LOAD_ON : !LOAD_ON);
}

void writeOutputs() {
  writeLoad(PIN_HEATER, heaterOn);
  writeLoad(PIN_MIST, mistOn);
  writeLoad(PIN_VENT, ventOn);
  writeLoad(PIN_CIRC_FAN, circOn);
}

// Time-proportioning: an output demand of pct % becomes ON for pct % of a
// fixed window. This suits loads that cannot (or should not) be PWM'd fast:
// the mist heads' own driver boards, zero-cross AC solid state relays, fans.
// On-times shorter than minOn are carried over to the next window instead
// of being dropped, so the average output still equals pct.
struct TimeProp {
  unsigned long start, onMs;
  float carry;
};
TimeProp tpHeater = {0, 0, 0}, tpMist = {0, 0, 0}, tpVent = {0, 0, 0};

bool timeProp(TimeProp &tp, float pct, unsigned long now,
              unsigned long window, unsigned long minOn) {
  if (now - tp.start >= window) {
    tp.start = now;
    float want = pct * (window / 100.0f) + tp.carry;
    if (want < minOn) {
      tp.onMs = 0;
      tp.carry = pct > 0 ? want : 0;
    } else {
      tp.onMs = want > window ? window : (unsigned long)want;
      tp.carry = 0;
    }
  }
  // pct == 0 (e.g. an alarm) switches off at once, not at the window end
  return pct > 0 && (now - tp.start) < tp.onMs;
}

// =====================================================================
//  Control (runs every CTRL_PERIOD_MS)
// =====================================================================
void readSensor() {
  float h = dht.readHumidity();
  float t = dht.readTemperature();
  if (isnan(h) || isnan(t)) {
    if (sensorFails < 255) sensorFails++;
    if (sensorFails >= SENSOR_FAIL_MAX) { tMeas = rhMeas = NAN; }
  } else {
    sensorFails = 0;
    tMeas = t + T_OFFSET;
    rhMeas = clampf(h + RH_OFFSET, 0, 100);
  }
}

// Filtered rate of change of a measurement (per second)
void trackSlope(float pv, float &prev, float &slope, float dt) {
  if (!isnan(prev)) slope += 0.1f * ((pv - prev) / dt - slope);
  prev = pv;
}

// PI with anti-windup + optional D on measurement.
// Outside +/-izone the integral pauses while the value is still moving
// towards the set-point faster than izone per 5 min (a ramp: no wind-up and
// no overshoot), but runs when the value has stalled short of the set-point
// (e.g. heater or mist only just big enough). It never integrates further
// into saturation.
float piStep(float sp, float pv, float &integ, float kp, float ki, float dTerm,
             float dt, float lo, float hi, float izone, float slope) {
  float e = sp - pv;
  float candidate = clampf(integ + ki * e * dt, lo, hi);
  float out = kp * e + candidate + dTerm;
  bool ramping = e * slope > 0 && fabs(slope) > izone / 300.0f;
  if ((fabs(e) <= izone || !ramping) && !((out > hi && e > 0) || (out < lo && e < 0)))
    integ = candidate;
  return clampf(kp * e + integ + dTerm, lo, hi);
}

void controlStep() {
  const float dt = CTRL_PERIOD_MS / 1000.0f;
  bool valid = !isnan(tMeas) && !isnan(rhMeas);

  // ---- alarms
  uint8_t a = alarms & ALM_BAND;
  if (sensorFails >= SENSOR_FAIL_MAX) a |= ALM_SENSOR;
  if (valid && tMeas >= T_ABS_MAX) a |= ALM_OVERTEMP;
  if ((a & ~alarms) != 0) {
    Serial.print(F("# ALARM 0x")); Serial.println(a, HEX);
  }
  alarms = a;
  alarmsMuted &= alarms;       // forget acknowledgements of cleared alarms

  inBandNow = false;
  if (!cfg.running) {
    heaterPct = mistPct = ventPct = rhOut = 0;
    circOn = false;
    tInt = rhInt = 0;
    tPrev = tMeas;
    rhPrev = rhMeas;
    return;
  }

  circOn = true;

  if (!valid) {                // no sensor -> fail safe
    heaterPct = mistPct = ventPct = 0;
    tPrev = rhPrev = NAN;
    return;
  }

  // ---- temperature loop -> heater
  float dTerm = 0;
  if (!isnan(tPrev)) dTerm = -T_KD * (tMeas - tPrev) / dt;
  trackSlope(tMeas, tPrev, tSlope, dt);
  trackSlope(rhMeas, rhPrev, rhSlope, dt);
  heaterPct = piStep(cfg.tSet, tMeas, tInt, T_KP, T_KI, dTerm, dt, 0, 100, T_IZONE, tSlope);
  if (roomMode(cfg.tSet)) { heaterPct = 0; tInt = 0; }
  if (alarms & ALM_OVERTEMP) { heaterPct = 0; tInt = 0; }

  // ---- humidity: one PI, split range
  //      rhOut > 0 -> mist heads, rhOut < 0 -> fresh-air blower
  float eRH = rhMeas - cfg.rhSet;
  float eT  = roomMode(cfg.tSet) ? 0 : tMeas - cfg.tSet;
  rhOut = piStep(cfg.rhSet, rhMeas, rhInt, RH_KP, RH_KI, 0, dt, -100, 100, RH_IZONE, rhSlope);
  mistPct = rhOut > 0 ? rhOut : 0;
  ventPct = rhOut < 0 ? -rhOut : 0;

  // ---- too hot with the heater already off: vent heat (hysteresis)
  static bool ventHeat = false;
  if (eT >= VENT_T_ON && heaterPct <= 0) ventHeat = true;
  else if (eT <= VENT_T_OFF)             ventHeat = false;
  if (ventHeat && ventPct < VENT_T_PCT) ventPct = VENT_T_PCT;
  if (alarms & ALM_OVERTEMP) { ventPct = 100; mistPct = 0; }

  // ---- tolerance statistics
  unsigned long now = millis();
  bool inBand = inBandNow = fabs(eT) <= T_TOL && fabs(eRH) <= RH_TOL;
  if (!stable) {
    if (!inBand) inBandSinceMs = 0;
    else if (inBandSinceMs == 0) inBandSinceMs = now;
    else if (now - inBandSinceMs >= STABLE_SEC * 1000UL) {
      stable = true;
      Serial.println(F("# STABLE: within tolerance"));
    }
  } else {
    statSamples++;
    if (inBand) statInBand++;
    if (fabs(eT)  > maxDevT)  maxDevT  = fabs(eT);
    if (fabs(eRH) > maxDevRH) maxDevRH = fabs(eRH);
    if (inBand) { outBandSinceMs = 0; alarms &= ~ALM_BAND; }
    else if (outBandSinceMs == 0) outBandSinceMs = now;
    else if (now - outBandSinceMs >= OUT_OF_BAND_ALARM_SEC * 1000UL) alarms |= ALM_BAND;
  }
}

// =====================================================================
//  Logging
// =====================================================================
void printHeader(Print &p) {
  p.println(F("timestamp,t_C,rh_pct,t_set_C,rh_set_pct,heater_pct,mist_pct,vent_pct,in_band,stable,alarms"));
}

void printTimestamp(Print &p) {
#ifdef USE_RTC
  Clock n;
  if (rtcRead(n)) {
    char b[20];
    snprintf_P(b, sizeof(b), PSTR("20%02u-%02u-%02u %02u:%02u:%02u"), n.yy, n.mo, n.dd, n.hh, n.mi, n.ss);
    p.print(b);
    return;
  }
#endif
  p.print(millis() / 1000UL);
}

void printNum(Print &p, float v, uint8_t dec) {
  char b[12];
  if (isnan(v)) p.print(F("NA")); else p.print(fmtFixed(b, v, 1, dec));
}

void writeRecord(Print &p) {
  printTimestamp(p);            p.print(',');
  printNum(p, tMeas, 1);        p.print(',');
  printNum(p, rhMeas, 1);       p.print(',');
  if (roomMode(cfg.tSet)) p.print(F("ROOM")); else printNum(p, cfg.tSet, 1);
  p.print(',');
  printNum(p, cfg.rhSet, 1);    p.print(',');
  printNum(p, heaterPct, 0);    p.print(',');
  printNum(p, mistPct, 0);      p.print(',');
  printNum(p, ventPct, 0);      p.print(',');
  p.print(inBandNow ? 1 : 0);   p.print(',');
  p.print(stable ? 1 : 0);      p.print(',');
  p.println(alarms, HEX);
}

#ifdef USE_SD
void logFileName(char *name) {          // one file per day: YYMMDD.CSV
#ifdef USE_RTC
  Clock n;
  if (rtcRead(n)) {
    snprintf_P(name, 13, PSTR("%02u%02u%02u.CSV"), n.yy, n.mo, n.dd);
    return;
  }
#endif
  strcpy(name, "DATALOG.CSV");
}
#endif

void logRecord() {
  writeRecord(Serial);
#ifdef USE_SD
  if (!sdOk || !cfg.running) return;
  char name[13];
  logFileName(name);
  File f = SD.open(name, FILE_WRITE);
  if (f) {
    if (f.size() == 0) printHeader(f);
    writeRecord(f);
    f.close();
  } else {
    sdOk = false;                       // card removed or faulty: look again later
    Serial.println(F("# SD write failed - card removed? will retry"));
  }
#endif
}

// =====================================================================
//  LCD (16x2) and keypad
// =====================================================================
void lcdRow(uint8_t row, const char *s) {
  char b[17];
  snprintf_P(b, sizeof(b), PSTR("%-16s"), s);
  lcd.setCursor(0, row);
  lcd.print(b);
}

// float -> fixed width text ("--.-" when invalid)
char *fmt(char *out, float v, int8_t width, uint8_t dec) {
  if (isnan(v)) { snprintf_P(out, width + 1, PSTR("%*s"), width, "--.-"); return out; }
  return fmtFixed(out, v, width, dec);
}

char *fmtSet(char *out, float tSet) {   // 4 characters: "35.0" or "ROOM"
  if (roomMode(tSet)) { strcpy_P(out, PSTR("ROOM")); return out; }
  return fmt(out, tSet, 4, 1);
}

void setBacklight(uint8_t c) {
  if (c != backlight) { lcd.setBacklight(c); backlight = c; }
}

const char *alarmText() {        // returns a PROGMEM string
  if (alarms & ALM_SENSOR)   return PSTR("!SENSOR FAIL");
  if (alarms & ALM_OVERTEMP) return PSTR("!OVER TEMP");
  if (alarms & ALM_BAND)     return PSTR("!OUT OF BAND");
  return PSTR("");
}

void drawScreen() {
  char l0[24], l1[24], a[8], b[8];

  if (inMenu) {
    const char *name;
    switch (menuItem) {
      case MENU_TSET:  name = PSTR("Set Temperature"); break;
      case MENU_RHSET: name = PSTR("Set Humidity");    break;
      case MENU_LOG:   name = PSTR("Log interval");    break;
      case MENU_RUN:   name = PSTR("Run / Stop");      break;
      default:         name = PSTR("Reset stats");     break;
    }
    snprintf_P(l0, sizeof(l0), PSTR(">%S"), name);
    switch (menuItem) {
      case MENU_TSET:  snprintf_P(l1, sizeof(l1), PSTR(" %s C"), fmtSet(a, edit.tSet)); break;
      case MENU_RHSET: snprintf_P(l1, sizeof(l1), PSTR(" %s %%RH"), fmt(a, edit.rhSet, 4, 1)); break;
      case MENU_LOG:   snprintf_P(l1, sizeof(l1), PSTR(" %u s"), edit.logSec); break;
      case MENU_RUN:   snprintf_P(l1, sizeof(l1), PSTR(" %s"), edit.running ? "RUN" : "STOP"); break;
      default:         snprintf_P(l1, sizeof(l1), PSTR(" %s"), resetRequested ? "YES" : "no"); break;
    }
    char row[20];
    snprintf_P(row, sizeof(row), PSTR("%-12.12s<  >"), l1);   // LEFT/RIGHT change value
    lcdRow(0, l0);
    lcdRow(1, row);
    setBacklight(0x6);                  // teal
    return;
  }

  switch (screen) {
    case SCR_MAIN: {
      const char *tag = !cfg.running ? "" : (alarms ? "!!" : (stable ? "OK" : ".."));
      snprintf_P(l0, sizeof(l0), PSTR("T%s/%sC %s"), fmt(a, tMeas, 5, 1), fmtSet(b, cfg.tSet), tag);
      if (alarms) snprintf_P(l1, sizeof(l1), PSTR("%S"), alarmText());
      else snprintf_P(l1, sizeof(l1), PSTR("H%s/%s%% %s"), fmt(a, rhMeas, 5, 1), fmt(b, cfg.rhSet, 4, 1),
                    cfg.running ? "RUN" : "STP");
      break;
    }
    case SCR_OUTPUTS:
      snprintf_P(l0, sizeof(l0), PSTR("Heat%3d%% Mst%3d%%"), (int)heaterPct, (int)mistPct);
      snprintf_P(l1, sizeof(l1), PSTR("Vent%3d%% Fan %s"), (int)ventPct, circOn ? "ON" : "OFF");
      break;
    case SCR_STATS:
      if (!stable) {
        unsigned long s = inBandSinceMs ? (millis() - inBandSinceMs) / 1000UL : 0;
        snprintf_P(l0, sizeof(l0), PSTR("Stabilizing..."));
        snprintf_P(l1, sizeof(l1), PSTR("in band %lus"), s);
      } else {
        float pct = statSamples ? 100.0f * statInBand / statSamples : 100.0f;
        snprintf_P(l0, sizeof(l0), PSTR("In band %s%%"), fmt(a, pct, 5, 1));
        snprintf_P(l1, sizeof(l1), PSTR("Max dT%s dH%s"), fmt(a, maxDevT, 3, 1), fmt(b, maxDevRH, 3, 1));
      }
      break;
    default: {                          // SCR_LOG
#ifdef USE_SD
      snprintf_P(l0, sizeof(l0), PSTR("Log %us SD %s"), cfg.logSec, sdOk ? "OK" : "--");
#else
      snprintf_P(l0, sizeof(l0), PSTR("Log %us serial"), cfg.logSec);
#endif
#ifdef USE_RTC
      Clock n;
      if (rtcRead(n)) {
        snprintf_P(l1, sizeof(l1), PSTR("%02u/%02u %02u:%02u:%02u"), n.dd, n.mo, n.hh, n.mi, n.ss);
      } else
#endif
      snprintf_P(l1, sizeof(l1), PSTR("No RTC"));
      break;
    }
  }
  lcdRow(0, l0);
  lcdRow(1, l1);

  if (!cfg.running)        setBacklight(0x7);   // white
  else if (alarms)         setBacklight(0x1);   // red
  else if (stable)         setBacklight(0x2);   // green
  else                     setBacklight(0x3);   // yellow
}

void menuAdjust(int8_t dir, uint8_t accel) {
  switch (menuItem) {
    case MENU_TSET: {                 // below T_SET_MIN -> ROOM, RIGHT from ROOM -> T_SET_MIN
      float t = roomMode(edit.tSet) ? (dir > 0 ? T_SET_MIN : T_ROOM)
                                    : edit.tSet + dir * 0.1f * accel;
      edit.tSet = t < T_SET_MIN - 0.05f ? T_ROOM : clampf(t, T_SET_MIN, T_SET_MAX);
      break;
    }
    case MENU_RHSET: edit.rhSet = clampf(edit.rhSet + dir * 0.5f * accel, RH_SET_MIN, RH_SET_MAX); break;
    case MENU_LOG: {
      int v = (int)edit.logSec + dir * (edit.logSec >= 60 ? 10 : 1) * accel;
      edit.logSec = v < 1 ? 1 : (v > 3600 ? 3600 : v);
      break;
    }
    case MENU_RUN:   edit.running = !edit.running; break;
    default:         resetRequested = !resetRequested; break;
  }
}

void handleKeys() {
  static uint8_t prev = 0;
  static unsigned long pressedAt = 0, lastRepeat = 0;
  unsigned long now = millis();
  uint8_t keys = lcd.readButtons();
  uint8_t pressed = keys & ~prev;
  prev = keys;

  if (keys) lastKeyMs = now;
  if (pressed) {
    pressedAt = lastRepeat = now;
    alarmsMuted = alarms;               // any key silences current alarms
  }

  // auto-repeat for LEFT/RIGHT in the menu (accelerates after 2 s)
  uint8_t accel = 1;
  if (!pressed && inMenu && (keys & (BUTTON_LEFT | BUTTON_RIGHT)) &&
      now - pressedAt > 500 && now - lastRepeat > 150) {
    lastRepeat = now;
    pressed = keys & (BUTTON_LEFT | BUTTON_RIGHT);
    accel = (now - pressedAt > 2000) ? 10 : 1;
    if (menuItem >= MENU_RUN) pressed = 0;   // no repeat for the toggles
  }
  if (!pressed) {
    if (inMenu && now - lastKeyMs > 30000UL) inMenu = false;          // timeout: discard
    return;
  }

  if (!inMenu) {
    if (pressed & BUTTON_SELECT) {
      inMenu = true; menuItem = 0; edit = cfg; resetRequested = false;
    } else if (pressed & BUTTON_UP) {
      screen = (screen + SCR_COUNT - 1) % SCR_COUNT;
    } else if (pressed & BUTTON_DOWN) {
      screen = (screen + 1) % SCR_COUNT;
    }
  } else {
    if (pressed & BUTTON_SELECT) {      // save and leave
      applySettings(edit);
      if (resetRequested) resetStats();
      inMenu = false;
      Serial.println(F("# settings saved"));
    } else if (pressed & BUTTON_UP) {
      menuItem = (menuItem + MENU_COUNT - 1) % MENU_COUNT;
    } else if (pressed & BUTTON_DOWN) {
      menuItem = (menuItem + 1) % MENU_COUNT;
    } else if (pressed & BUTTON_RIGHT) {
      menuAdjust(+1, accel);
    } else if (pressed & BUTTON_LEFT) {
      menuAdjust(-1, accel);
    }
  }
  lastLcdMs = 0;                        // redraw immediately
}

// =====================================================================
//  Serial commands
// =====================================================================
// STATUS = one CSV record (see HEADER) + run state and tolerance statistics
void printStatus() {
  writeRecord(Serial);
  Serial.print(F("# run="));     Serial.print(cfg.running);
  Serial.print(F(" log_s="));    Serial.print(cfg.logSec);
  Serial.print(F(" stable="));   Serial.print(stable);
  Serial.print(F(" in_band%="));
  printNum(Serial, statSamples ? 100.0f * statInBand / statSamples : 0, 1);
  Serial.print(F(" max_dT="));   printNum(Serial, maxDevT, 2);
  Serial.print(F(" max_dRH="));  printNum(Serial, maxDevRH, 2);
  Serial.println();
}

void printHelp() {
  Serial.println(F("# HELP | STATUS | DEVICES | RUN | STOP | RESET | HEADER"));
  Serial.println(F("# SET T <C|ROOM> | SET RH <%> | SET LOG <s>"));
  Serial.println(F("# TIME YYYY-MM-DD HH:MM:SS"));
}

void handleCommand(char *line) {
  char *cmd = strtok(line, " ");
  if (!cmd) return;
  Settings s = cfg;
  bool ok = true;

  if      (!strcasecmp(cmd, "HELP"))   printHelp();
  else if (!strcasecmp(cmd, "STATUS")) printStatus();
  else if (!strcasecmp(cmd, "DEVICES")) printDevices();
  else if (!strcasecmp(cmd, "HEADER")) printHeader(Serial);
  else if (!strcasecmp(cmd, "RESET"))  resetStats();
  else if (!strcasecmp(cmd, "RUN"))    { s.running = 1; applySettings(s); }
  else if (!strcasecmp(cmd, "STOP"))   { s.running = 0; applySettings(s); }
  else if (!strcasecmp(cmd, "SET")) {
    char *key = strtok(NULL, " ");
    char *val = strtok(NULL, " ");
    float v = val ? parseNum(val) : NAN;
    if (!key || !val) ok = false;
    else if (!strcasecmp(key, "T")  && !strcasecmp(val, "ROOM"))          s.tSet = T_ROOM;
    else if (!strcasecmp(key, "T")  && v >= T_SET_MIN  && v <= T_SET_MAX)  s.tSet = v;
    else if (!strcasecmp(key, "RH") && v >= RH_SET_MIN && v <= RH_SET_MAX) s.rhSet = v;
    else if (!strcasecmp(key, "LOG") && v >= 1 && v <= 3600)               s.logSec = (uint16_t)v;
    else ok = false;
    if (ok) applySettings(s);
  }
#ifdef USE_RTC
  else if (!strcasecmp(cmd, "TIME")) {
    char *rest = strtok(NULL, "");
    if (!rtcOk) Serial.println(F("# RTC not found"));
    ok = rest && rtcOk && rtcSetFromText(rest);
  }
#endif
  else ok = false;

  Serial.println(ok ? F("# OK") : F("# ERR (type HELP)"));
}

void serialLoop() {
  while (Serial.available()) {
    char c = Serial.read();
    if (c == '\n' || c == '\r') {
      if (serialLen) { serialBuf[serialLen] = 0; handleCommand(serialBuf); serialLen = 0; }
    } else if (serialLen < sizeof(serialBuf) - 1) {
      serialBuf[serialLen++] = c;
    }
  }
}

// =====================================================================
//  Optional modules: detect at power-on, and again every DEVICE_RETRY_MS
// =====================================================================
bool i2cPresent(uint8_t addr) {
  Wire.beginTransmission(addr);
  return Wire.endTransmission() == 0;
}

void checkDevices() {
  // LCD keypad shield (I2C): (re)initialise when it appears
  bool l = i2cPresent(LCD_I2C_ADDR);
  if (l && !lcdOk) {
    lcd.begin(16, 2);
    backlight = 0xFF;                   // force the colour to be resent
    lcd.clear();
    if (lastDeviceCheckMs) Serial.println(F("# LCD found"));
  } else if (!l && lcdOk) {
    Serial.println(F("# LCD lost"));
  }
  lcdOk = l;

#ifdef USE_RTC
  bool r = rtcOk ? i2cPresent(RTC_ADDR) : rtcBegin();
  if (r != rtcOk && lastDeviceCheckMs) Serial.println(r ? F("# RTC found") : F("# RTC lost"));
  rtcOk = r;
#endif

#ifdef USE_SD
  if (!sdOk) {
    // SD.begin() blocks for up to ~2 s when no card is fitted: hold the
    // heater and mist off meanwhile (the safe direction) and keep the
    // watchdog fed.
    heaterOn = mistOn = false;
    writeOutputs();
  #ifdef __AVR__
    wdt_reset();
  #endif
    SD.end();
    sdOk = SD.begin(PIN_SD_CS);
    if (sdOk && lastDeviceCheckMs) Serial.println(F("# SD card found"));
  }
#endif
}

// one line per module, e.g. "# LCD OK | RTC OK 2026-10-14 09:00:00 | SD OK | DHT22 OK"
void printDevices() {
  Serial.print(F("# LCD "));    Serial.print(lcdOk ? F("OK") : F("not found"));
#ifdef USE_RTC
  Serial.print(F(" | RTC "));
  Clock n;
  if (!rtcOk) Serial.print(F("not found"));
  else if (rtcRead(n) && n.yy >= 24) { Serial.print(F("OK ")); printTimestamp(Serial); }
  else Serial.print(F("OK, time not set (use TIME)"));
#endif
#ifdef USE_SD
  Serial.print(F(" | SD "));    Serial.print(sdOk ? F("OK") : F("not found"));
#endif
  Serial.print(F(" | DHT22 ")); Serial.println(isnan(tMeas) ? F("not responding") : F("OK"));
}

// =====================================================================
//  Buzzer and status LEDs
// =====================================================================
void setLeds(bool run, bool alarm, bool heat, bool mist) {
  digitalWrite(PIN_LED_RUN,   run   ? LED_ON : !LED_ON);
  digitalWrite(PIN_LED_ALARM, alarm ? LED_ON : !LED_ON);
  digitalWrite(PIN_LED_HEAT,  heat  ? LED_ON : !LED_ON);
  digitalWrite(PIN_LED_MIST,  mist  ? LED_ON : !LED_ON);
}

// buzzer : 0.4 s beep every 1.2 s for alarms not yet acknowledged
//          (any key press acknowledges)
// RUN    : off = stopped, 1 Hz blink = settling / out of tolerance,
//          steady = stable within tolerance
// ALARM  : off = none, 2.5 Hz blink = new alarm, steady = acknowledged
// HEAT / MIST : follow the heater and mist-head outputs
void updateIndicators(unsigned long now) {
  bool fresh = alarms & ~alarmsMuted;
  digitalWrite(PIN_BUZZER, (fresh && (now / 400UL) % 3 == 0) ? HIGH : LOW);

  bool slow = (now / 500UL) & 1, fast = (now / 200UL) & 1;
  bool run   = cfg.running && (stable && !alarms ? true : slow);
  bool alarm = alarms && (fresh ? fast : true);
  setLeds(run, alarm, heaterOn, mistOn);
}

// =====================================================================
//  setup / loop
// =====================================================================
void setup() {
#ifdef __AVR__
  wdt_disable();
#endif
  pinMode(PIN_HEATER, OUTPUT);
  pinMode(PIN_MIST, OUTPUT);
  pinMode(PIN_VENT, OUTPUT);
  pinMode(PIN_CIRC_FAN, OUTPUT);
  pinMode(PIN_BUZZER, OUTPUT);
  pinMode(PIN_LED_RUN, OUTPUT);
  pinMode(PIN_LED_ALARM, OUTPUT);
  pinMode(PIN_LED_HEAT, OUTPUT);
  pinMode(PIN_LED_MIST, OUTPUT);
  setLeds(true, true, true, true);      // lamp test while starting up
  digitalWrite(PIN_BUZZER, HIGH);       // short start-up beep
  delay(150);
  digitalWrite(PIN_BUZZER, LOW);
  writeOutputs();                       // everything off

  Serial.begin(SERIAL_BAUD);
  Serial.println(F("# SCC Chamber Environmental Control"));

  loadSettings();
  dht.begin();

  Wire.begin();
#ifdef __AVR__
  Wire.setWireTimeout(I2C_TIMEOUT_US, true);   // never hang on a bad I2C bus
#endif
#ifdef USE_SD
  pinMode(PIN_SD_CS, OUTPUT);
  digitalWrite(PIN_SD_CS, HIGH);
#endif
  checkDevices();
  if (lcdOk) {
    lcdRow(0, "SCC Env Control");
    lcdRow(1, "starting...");
  }

  printHelp();
  delay(2000);                          // DHT22 power-up time
  readSensor();
  printDevices();
  printHeader(Serial);
  tPrev = tMeas;
  lastCtrlMs = lastLogMs = lastDeviceCheckMs = millis();

#ifdef __AVR__
  wdt_enable(WDTO_8S);
#endif
}

void loop() {
#ifdef __AVR__
  wdt_reset();
#endif
  unsigned long now = millis();

  if (now - lastCtrlMs >= CTRL_PERIOD_MS) {
    lastCtrlMs += CTRL_PERIOD_MS;
    readSensor();
    controlStep();
  }

  heaterOn = timeProp(tpHeater, heaterPct, now, HEATER_WINDOW_MS, HEATER_MIN_ON_MS);
  mistOn   = timeProp(tpMist,   mistPct,   now, MIST_WINDOW_MS,   MIST_MIN_ON_MS);
  ventOn   = timeProp(tpVent,   ventPct,   now, VENT_WINDOW_MS,   VENT_MIN_ON_MS);
  writeOutputs();

  if (now - lastDeviceCheckMs >= DEVICE_RETRY_MS) {
    lastDeviceCheckMs = now;
    checkDevices();
  }

  if (lcdOk && now - lastKeyPollMs >= 50) {
    lastKeyPollMs = now;
    handleKeys();
  }
  serialLoop();

  if (now - lastLogMs >= (unsigned long)cfg.logSec * 1000UL) {
    lastLogMs = now;
    logRecord();
  }

  if (lcdOk && now - lastLcdMs >= 500) {
    lastLcdMs = now;
    drawScreen();
  }

  updateIndicators(now);
}
