iisangon-gif/Stress-Corrosion-Cracking-Test-Chamber/(commit log)

2026-10-14 Add SCC chamber temperature/humidity controller for Arduino UNO
    Environmental control for a small stress corrosion cracking test chamber:
    DHT22 sensor, USB ultrasonic humidifier, 12 V PTC heater, exhaust and
    circulation fans, I2C RGB LCD keypad shield and SD/RTC data logging.
    - Firmware: PID temperature loop and split-range humidity PI
    (humidifier time-proportioning / exhaust fan PWM), integral zones,
    set-points via keypad or serial (EEPROM), CSV logging, alarms,
    watchdog. Fits the UNO: 32,008 B flash, 1,454 B RAM.
    - Docs: control design, parts list, wiring, operation and tuning.
    - Tools: serial logger and log plot / tolerance report.
    - Tests: host build of the firmware with UI tests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
    [SCC_EnvControl.ino, chamber_sim.cpp, config.h]
2026-10-14 Switch to 4-head salt-fog mist, SSR-ready outputs, drop level/door inputs
    - Mist: 4 USB ultrasonic heads in 3.5 wt% NaCl on one switched 5 V rail
    (PIN_MIST, D3); water-level input and its alarm removed to keep the
    UNO R3 (free pins now D4, D9, A0-A3).
    - All outputs are on/off time-proportioned (heater 2 s, mist 5 s,
    vent 10 s windows) so zero-cross AC SSRs, DC SSRs or MOSFETs work.
    - Corrosion: heater becomes a silicone pad on the outer wall and the
    exhaust fan a fresh-air blower outside the fog; heat-venting only as a
    last resort (>1.5 C) since it dries the fog. Buzzer pin renamed
    PIN_ALARM (buzzer or lighted push button LED).
    - Retuned temperature PID for the wall-heater lag (1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
    [SCC_EnvControl.ino, chamber_sim.cpp, config.h, plot_log.py, ui_test.cpp]
2026-10-14 Set operating range 20-40 C/ROOM and 20-80 %RH; short timed mist bursts
    - Set-point ranges: 20-40 C plus ROOM mode (heater off, temperature only
    logged; LEFT below 20 C in the menu or SET T ROOM), 20-80 %RH.
    - Mist heads (own drivers, switched together via their 5 V supply) are
    sprayed in timed bursts: MOSFET on the 5 V rail (default, 4 s window,
    >= 0.3 s bursts) or SSR on the adapter's 230 V input
    (MIST_SWITCH_SSR 1, 6 s window, >= 1 s bursts). Short bursts are what
    keeps RH within +/-2 % with 4 heads in a 40-60 L box.
    - Humidity PI retuned (Kp 3, Ki 0.006). Removed "Reset stats" menu item
    and shortened serial help to keep flash headroom (31,958 B).
    - Simulator: set-points per s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
    [SCC_EnvControl.ino, chamber_sim.cpp, config.h, ui_test.cpp]
2026-10-14 Mist heads: DC/DC SSR on D3 feeding the 4 drivers from 12->5 V step-down
    - D3 drives a DC/DC SSR that switches the supply of all 4 mist-head
    drivers; firmware logic unchanged. Recommended placement is in the
    12 V feed of the 12->5 V step-down so the SSR's on-state drop does not
    reduce the 5 V; 5 V-side placement documented with checks (load range,
    >= 4.75 V at the drivers, polarity, leakage).
    - Renamed option MIST_SWITCH_SSR -> MIST_AC_SIDE_SWITCH so a DC SSR is
    clearly the default fast switch (0.3 s bursts); 1 only for switching
    the 230 V input of a USB adapter.
    - Docs: parts list (DC/DC SSR, >= 5 A step-down, 12 V >= 3 A), wiring,
    control design, operation and Thai notes upda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
    [config.h]
2026-10-14 200 L plastic chamber with in-chamber heater module; fix stalled integral
    - Chamber 50 x 80 x 50 cm (200 L): heat-loss and mist sizing (4 heads
    sufficient; heater 200 W insulated / 300 W bare incl. mist latent heat).
    - Heater module inside the fog (silicone pad on finned Al heat sink +
    IP68 fan on D7): corrosion and shock mitigations documented - 24 VDC
    pad via DC/DC SSR preferred, coated fins, neutral-cure sealing, no
    joints inside, KSD301 75 C + ~100 C thermal fuse for a stopped fan,
    placement away from the mist under a drip shield.
    - Firmware fix: the integral zone could lock the integral out when the
    heater or mist was only just big enough (stuck ~2 C / ~8 %RH short).
    Outsi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
    [SCC_EnvControl.ino, chamber_sim.cpp, config.h]
2026-10-14 Switch to Arduino Mega 2560; restore buzzer; add four status LEDs
    - Board: Arduino Mega 2560 (build stops with a clear #error if another
    board is selected). Flash ~33 KB / 256 KB, RAM ~1.5 KB / 8 KB; full
    serial help text restored.
    - Buzzer back on D8 (beeps for unacknowledged alarms). Status LEDs:
    D22 green RUN (steady = in tolerance, blink = settling), D24 red ALARM
    (fast blink = new, steady = acknowledged), D26 amber HEATER, D28 blue
    MIST. Lamp test + short beep at power-on. Float and door switches
    remain not fitted.
    - UI test checks buzzer/LED behaviour; CI compiles for arduino:avr:mega.
    - Docs: Mega pin map, using UNO-size shields on the Mega (I2C on
    SDA/SCL header, Data L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
    [SCC_EnvControl.ino, config.h, serial_logger.py, ui_test.cpp]
2026-10-14 Option A logging (microSD module + DS3231); run with modules missing
    - Defaults for the new data-logging hardware: DS3231 (RTC_IS_PCF8523 0)
    and a 6-pin microSD module on D50-D53 (PIN_SD_CS 53).
    - I2C timeout (Wire.setWireTimeout) so a loose or shorted I2C wire
    resets the bus instead of hanging the controller.
    - The controller runs with any module missing and looks again every
    minute: an SD card, DS3231 or LCD fitted later is picked up without a
    reset; a removed SD card is detected on the next write and searched
    for again (heater/mist held off during the ~2 s SD search).
    - Power-on device report and new DEVICES command, e.g.
    "# LCD OK | RTC OK 2026-10-14 09:00:00 | SD not found |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
    [SCC_EnvControl.ino, chamber_sim.cpp, config.h, devices_test.cpp]
